nva1773/Irda-To-Uart/Pictures/Proteus.jpg

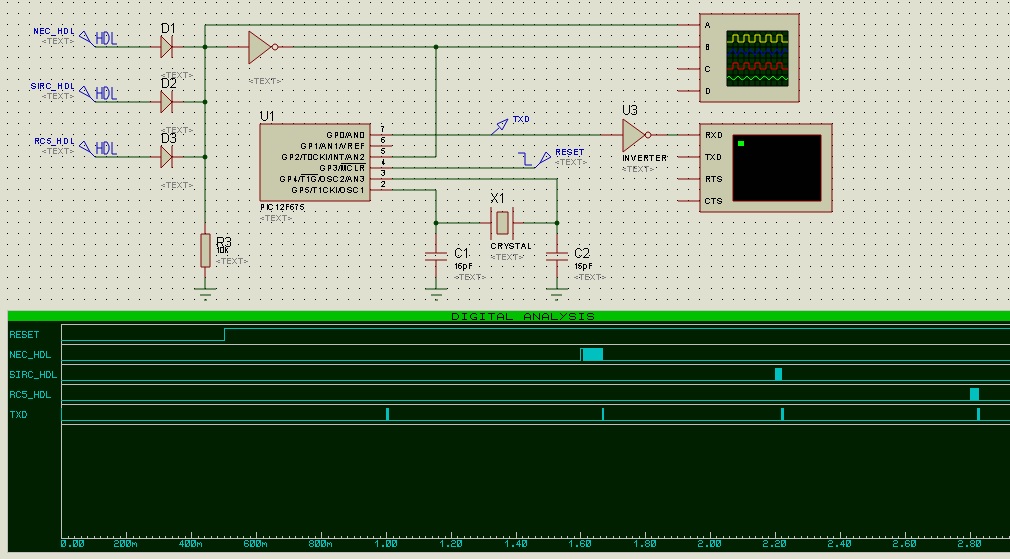
Pictures/Proteus.jpg
