nva1773/Irda-To-Uart/Software/IrdaRemote/Resources/Irda_Shem_514px.png

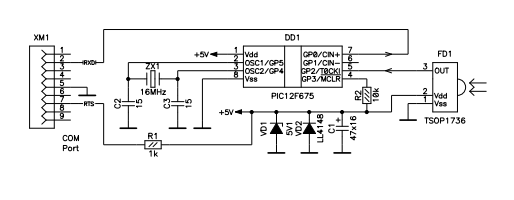
Software/IrdaRemote/Resources/Irda_Shem_514px.png
