nva1773/Irda-To-Uart/Hard/Circuit.pdf

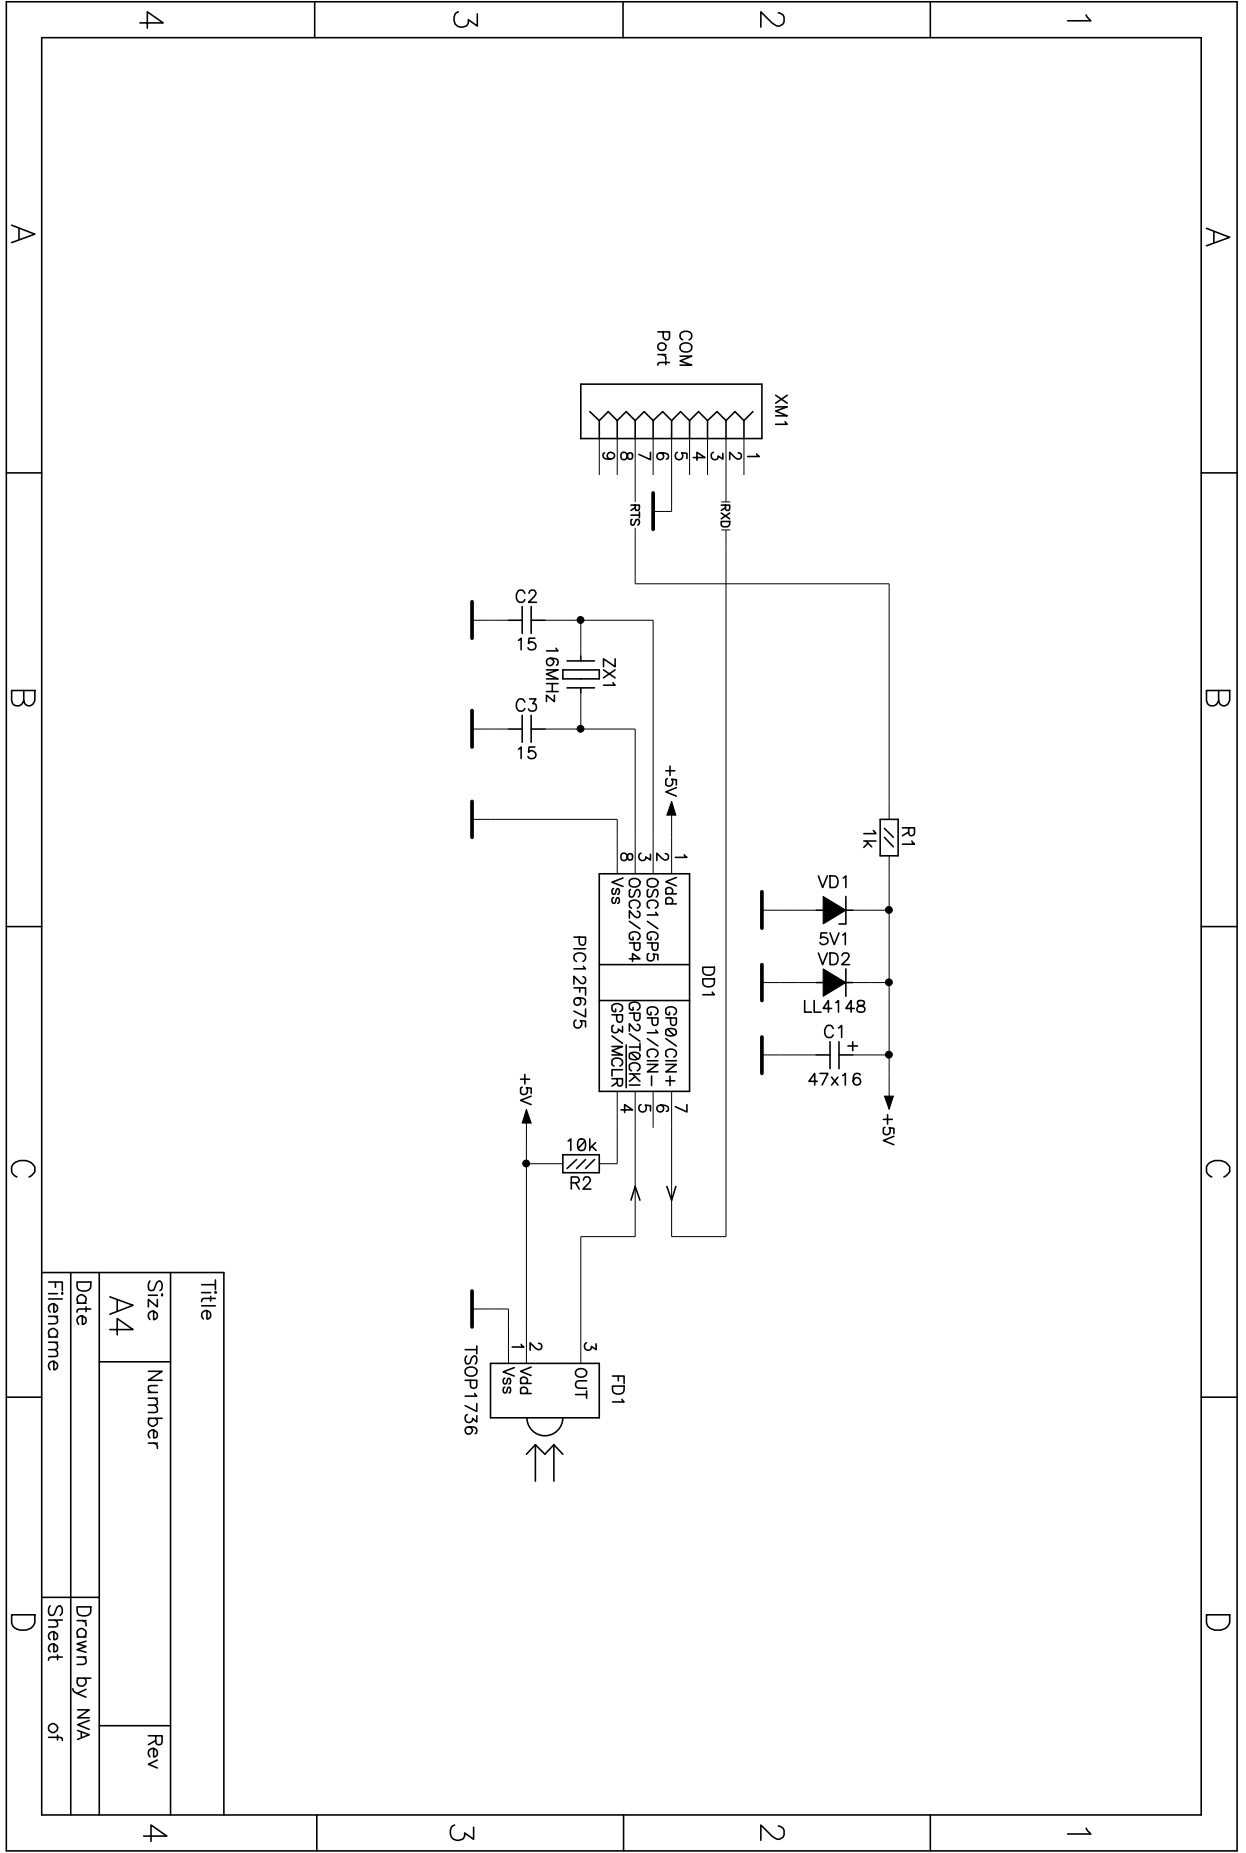
[picture p5: page 1]
