nva1773/Irda-To-Uart/(list of files, drawings)

Other design files:
Hard/IrDaToUART.pcb
Proteus/IrDaToUART.DSN
